T3gi/System/docs/pinout.md

# Схема підключення та Pinout

## 1. Зведена таблиця підключення

| Пін МК | Номер AF | Периферія і сигнал | Роз'єм Nucleo (Morpho / Arduino) | Пін пристрою | Напруга | Pull-up/down | Джерело | Причина вибору (Чому саме цей пін) |
| :--- | :--- | :--- | :--- | :--- | :--- | :--- | :--- | :--- |
| **Камера OV7670** | | | | | | | | |
| PB8 | AF4 | I2C1_SCL | CN5 pin 10 (D15) | SIO_C | 3.0V | Pull-up (МК) | DS10314[pg:48]; UM1724[pg:44]; OV7670[pg:4-5] | Апаратна підтримка I2C1_SCL. Стандартний пін Arduino роз'єму. |
| PB9 | AF4 | I2C1_SDA | CN5 pin 9 (D14) | SIO_D | 3.0V | Pull-up (МК) | DS10314[pg:48]; UM1724[pg:44]; OV7670[pg:4-5] | Апаратна підтримка I2C1_SDA. Стандартний пін Arduino роз'єму. |
| PA8 | AF0 | MCO_1 (Clock) | CN9 pin 8 (D7) | XCLK | 3.0V | Без підтяжки | DS10314[pg:48]; UM1724[pg:44]; OV7670[pg:4-5] | Єдиний пін (MCO_1), що може апаратно виводити тактову частоту з ядра МК. |
| PC0 | Input | GPIO_Input | CN7 pin 38 | D0 | 3.0V | Pull-down (МК)| DS10314[pg:48]; UM1724[pg:59]; OV7670[pg:4-5] | Початок цілісного порту GPIOC для паралельного зчитування байта за 1 такт. |
| PC1 | Input | GPIO_Input | CN7 pin 36 | D1 | 3.0V | Pull-down (МК)| DS10314[pg:48]; UM1724[pg:59]; OV7670[pg:4-5] | Продовження цілісного порту GPIOC. |
| PC2 | Input | GPIO_Input | CN7 pin 35 | D2 | 3.0V | Pull-down (МК)| DS10314[pg:48]; UM1724[pg:59]; OV7670[pg:4-5] | Продовження цілісного порту GPIOC. |
| PC3 | Input | GPIO_Input | CN7 pin 37 | D3 | 3.0V | Pull-down (МК)| DS10314[pg:48]; UM1724[pg:59]; OV7670[pg:4-5] | Продовження цілісного порту GPIOC. |
| PC4 | Input | GPIO_Input | CN10 pin 34 | D4 | 3.0V | Pull-down (МК)| DS10314[pg:48]; UM1724[pg:59]; OV7670[pg:4-5] | Продовження цілісного порту GPIOC. |
| PC5 | Input | GPIO_Input | CN10 pin 6 | D5 | 3.0V | Pull-down (МК)| DS10314[pg:48]; UM1724[pg:59]; OV7670[pg:4-5] | Продовження цілісного порту GPIOC. |
| PC6 | Input | GPIO_Input | CN10 pin 4 | D6 | 3.0V | Pull-down (МК)| DS10314[pg:48]; UM1724[pg:59]; OV7670[pg:4-5] | Продовження цілісного порту GPIOC. |
| PC7 | Input | GPIO_Input | CN10 pin 19 | D7 | 3.0V | Pull-down (МК)| DS10314[pg:48]; UM1724[pg:59]; OV7670[pg:4-5] | Кінець цілісного порту GPIOC. |
| PA0 | Input | EXTI0 | CN8 pin 1 (A0) | PCLK | 3.0V | Без підтяжки | DS10314[pg:48]; UM1724[pg:44]; OV7670[pg:4-5] | Канал EXTI0 для найшвидшого переривання по піксельному такту. |
| PA1 | Input | GPIO_Input | CN8 pin 2 (A1) | VSYNC | 3.0V | Без підтяжки | DS10314[pg:48]; UM1724[pg:44]; OV7670[pg:4-5] | Сусідній вільний пін, зручно виведений на колодку A1 для підключення. |
| PA4 | Input | GPIO_Input | CN8 pin 3 (A2) | HREF | 3.0V | Без підтяжки | DS10314[pg:48]; UM1724[pg:44]; OV7670[pg:4-5] | Сусідній вільний пін, зручно виведений на колодку A2 для підключення. |
| PB1 | Output| GPIO_Output | CN10 pin 24 | RESET | 3.0V | Без підтяжки | DS10314[pg:48]; UM1724[pg:59]; OV7670[pg:4-5] | Вільні піни порту B, розташовані поруч на роз'ємі Morpho для зручності шлейфу. |
| PB2 | Output| GPIO_Output | CN10 pin 22 | PWDN | 3.0V | Без підтяжки | DS10314[pg:48]; UM1724[pg:59]; OV7670[pg:4-5] | Сусідній до PB1 пін, використовується для живлення. |
| **MPU-6050 (GY-89)** | | | | | | | | |
| PB8 | AF4 | I2C1_SCL | Спільна лінія | SCL | 3.3V | Pull-up (модуль)| DS10314[pg:48]; MPU-6000P[pg:5]| Підключено паралельно на апаратну шину I2C1 разом з камерою. |
| PB9 | AF4 | I2C1_SDA | Спільна лінія | SDA | 3.3V | Pull-up (модуль)| DS10314[pg:48]; MPU-6000P[pg:5]| Підключено паралельно на апаратну шину I2C1 разом з камерою. |
| **SPI Flash W25Q64** | | | | | | | | |
| PB13 | AF5 | SPI2_SCK | CN10 pin 30 | CLK | 3.3V | Без підтяжки | DS10314[pg:48]; W25Q64JV[pg:5,58]| Апаратна підтримка SPI2. Використано, бо SPI1 зайнятий таймером серво. |
| PB14 | AF5 | SPI2_MISO | CN10 pin 28 | MISO | 3.3V | Без підтяжки | DS10314[pg:48]; W25Q64JV[pg:5,58]| Апаратна підтримка SPI2. Піни PB13-PB15 йдуть підряд на Morpho. |
| PB15 | AF5 | SPI2_MOSI | CN10 pin 26 | MOSI | 3.3V | Без підтяжки | DS10314[pg:48]; W25Q64JV[pg:5,58]| Апаратна підтримка SPI2. |
| PB12 | Output| GPIO_Output | CN10 pin 16 | CS | 3.3V | Pull-up (МК) | DS10314[pg:48]; W25Q64JV[pg:5,58]| Сусідній до шини SPI2 пін для зручного підключення шлейфом (NSS програмний). |
| **Сервопривід** | | | | | | | | |
| PA6 | AF2 | TIM3_CH1 | CN5 pin 5 (D12) | Signal | 5.0V | Без підтяжки | DS10314[pg:48]; UM1724[pg:44]| Має апаратний вивід каналу таймера (TIM2_CH1) для генерації ШІМ (PWM). |
# Arduino - CN5,CN6,CN8,CN9 
# Morpho - CN7,CN10

## 2. Таблиця адрес і ідентифікаторів пристроїв

| Пристрій | Шина | Адреса вибору на модулі | Робоча I2C-адреса (Write / Read) | Очікувані значення регістрів ідентифікації | Джерело |
| :--- | :--- | :--- | :--- | :--- | :--- |
| **OV7670** | I2C1 (SCCB) | Апаратно фіксована | `0x42` (Write) / `0x43` (Read) | PID (`0x0A`) = `0x76`, VER (`0x0B`) = `0x70` | OV7670 Datasheet [pg:10-23] |
| **MPU-6050** | I2C1 | Пін AD0 підтягнутий до GND (на модулі GY-89) | `0xD0` (Write) / `0xD1` (Read) [7-bit: `0x68`] | WHO_AM_I (Регістр 117 / `0x75`) = `0x68` | MPU-6000 [pg:45] |
| **W25Q64JV** | SPI2 | Не застосовно (використовується Chip Select) | Не застосовно (SPI) | Команда `0x9F` (JEDEC) повертає: `0xEF4017` | W25Q64JV Datasheet [pg:20, 58] |

## 3. Параметри шин та тактування

* **SYSCLK (Частота ядра):**
  * **Значення:** Максимальна частота STM32F411 становить 100 МГц.
  * **Джерело:** DS10314 \[pg: 1\]

* **I2C1 (Камера OV7670 та MPU-6050):**
  * **Режим:** Standard Mode (100 kHz).
  * **Дерево тактування:** Підключено до шини APB1 (максимум 50 МГц). Якщо `SYSCLK = 84 МГц`, то `APB1 = 42 МГц` (Prescaler = 2).
  * **Розрахунок:** Прескалер шини I2C розраховується апаратно (зазвичай через бібліотеку HAL) так, щоб з базової частоти 42 МГц отримати період тактування $10 \mu s$ (100 кГц).
  * **Джерело:** DS10314 \[pg: 54-57\]

* **SPI2 (Флеш-пам'ять W25Q64JV):**
  * **Режим:** Full-Duplex Master, SPI Mode 0 (CPOL=0, CPHA=0).
  * **Дерево тактування:** Підключено до шини APB1 (наприклад, 42 МГц).
  * **Прескалер та розрахунок:** Обрано дільник **Prescaler = 4**. Робоча частота шини складе: `42 МГц / 4 = 10.5 МГц`. 
  * **Обґрунтування:** Частота 10.5 МГц є оптимальною для стабільної передачі сигналів макетними проводами і повністю вписується в ліміт мікросхеми пам'яті (яка підтримує частоти до 133 МГц).
  * **Джерела:** DS10314 \[pg: 54-57\]; W25Q64JV Datasheet \[pg: 4, 11, 62\]

* **MCO_1 (Тактування камери XCLK):**
  * **Режим:** Апаратний вивід тактового сигналу через альтернативну функцію AF0 на пін PA8.
  * **Прескалер та розрахунок:** Як джерело обрано генератор **HSI (16 МГц)**. Подільник для MCO_1 встановлено на **2**. Розрахунок вихідної частоти: `16 МГц / 2 = 8 МГц`. 
  * **Обґрунтування:** Частота 8 МГц необхідна для тактування внутрішньої логіки сенсора OV7670.
  * **Джерело:** DS10314 \[pg: 48-53\]

## 4. Бюджет живлення

*Джерело струму для логічної лінії 3V3 плати Nucleo: вбудований LDO-регулятор U4, максимальний струм якого обмежений на рівні **500 мА**. (Джерело: UM1724 [pg: 23])*

| Пристрій | Джерело живлення | Робоче (типове) споживання | Пікове (максимальне) споживання | Обґрунтування окремого джерела живлення |
| :--- | :--- | :--- | :--- | :--- |
| **OV7670** | Nucleo 3.3V | ~15 мА | ~20 мА | - |
| **MPU-6050** | Nucleo 3.3V | ~3.9 мА | ~5 мА | - |
| **W25Q64JV** | Nucleo 3.3V | ~15 мА | ~25 мА | - |
| **STM32F411** | Nucleo 3.3V | ~20 мА | ~25 мА | - |
| ***Всього (лінія 3.3V)*** | | ***~53.9 мА*** | ***~75 мА*** | **Запас по струму для лінії 3.3V: ~425 мА (більше 80% запасу). Це гарантує стабільну роботу цифрової логіки.** |
| **SG92R (Серво)** | **Nucleo 5V (від USB)** | ~100 мА | **> 500 мА** | Сервопривід є індуктивним навантаженням. Його пускові струми або струми при блокуванні ротора перевищують весь ліміт стабілізатора U4. Підключення до лінії 3.3V гарантовано викличе просадку напруги та апаратне перезавантаження (Brownout) мікроконтролера. Тому силове живлення винесено на лінію 5V безпосередньо від USB. |

## 5. Аргументація архітектурних рішень
* **Зчитування камери цілим портом (PC0-PC7):** Оскільки МК не має апаратного інтерфейсу DCMI, дані зчитуються програмно. Підключення D0-D7 суворо до одного порту `GPIOC` дозволяє зчитати 8-бітний піксель за одну атомарну операцію (`GPIOC->IDR & 0xFF`), що життєво необхідно для відеопотоку.
* **Апаратні шини (I2C1, SPI2):** Піни PB8/PB9 та PB13-PB15 обрані через апаратну підтримку цих інтерфейсів, що знімає процесорне навантаження (не потрібен bit-banging) і дає можливість у майбутньому підключити DMA до SPI.

## 6. Відхилені варіанти (Альтернативні розкладки)
1. **Відхилений варіант 1: Використання піна PA5 (TIM2_CH1) для генерації ШІМ-сигналу сервопривода.**
   * *Причина відмови:* На платі Nucleo пін PA5 апаратно з'єднаний із вбудованим зеленим світлодіодом (LD2). Якби ми залишили на ньому керування сервоприводом, постійна генерація високочастотного ШІМ-сигналу викликала б неконтрольоване та дратівливе мерехтіння цього світлодіода під час роботи пристрою. Крім того, це створює непотрібне електричне навантаження на лінію. Тому керування було перенесено на сусідній, повністю вільний пін PA6 (TIM3_CH1).
2. **Відхилений варіант 2: Зчитування пікселів камери (D0-D7) через випадкові вільні піни GPIOA та GPIOB.**
   * *Причина відмови:* Якби контакти D0-D7 були рознесені на різні порти (наприклад, D0 на PA2, D1 на PB4 тощо), обробка кожного переривання PCLK вимагала б кількох операцій зчитування, маскування (AND) та бітових зсувів. Це займає десятки тактів процесора, через що МК банально не встигав би зчитувати пікселі на частоті камери 8 МГц.
