T3gi/System/docs/limitations.md

# Реєстр обмежень архітектури Super Loop (на базі аналізу тестування)

У цьому документі наведено 5 критичних обмежень поточної архітектури "суперциклу" (Super Loop), виявлених під час тестування системи (зокрема сценаріїв зйомки та навантаження), а також шляхи їх вирішення за допомогою ОСРЧ (RTOS).

## 1. Затримка реакції на апаратні події (Відсутність витіснення)
*   **Опис проблеми:** У суперциклі всі задачі виконуються послідовно. Якщо функція `App_Poll()` "застрягає" на тривалій операції (наприклад, читання кадру камери через блокуючий SPI або вивантаження масиву 22 КБ по UART), обробка інших подій зупиняється. У нашому випадку натискання кнопки `B1_Pin` фіксується в перериванні миттєво (`btn_pending = 1`), але його *обробка* (виклик логіки камери) затримується на сотні мілісекунд (максимум до 107 мс і більше), оскільки суперцикл зайнятий іншим кодом.
*   **Рішення з RTOS:** ОСРЧ підтримує **витіснювальну багатозадачність (preemptive scheduling)**. Обробник кнопки можна винести у задачу з високим пріоритетом. Як тільки користувач натискає кнопку, RTOS негайно призупиняє задачу передачі кадру (яка матиме нижчий пріоритет) і передає управління задачі обробки кнопки, зводячи затримку до кількох мікросекунд.

## 2. Неможливість дотримання жорсткого таймінгу (Джитер періодичних задач)
*   **Опис проблеми:** Подія `TICK`, яка має генеруватися рівно кожні 1000 мс для опитування датчика температури та освітленості, страждає від величезного джитера (відхилення часу). У сценарії навантаження джитер перевищує 2 секунди. Суперцикл не гарантує детермінованості: час виконання циклу постійно "плаває" залежно від гілок `if/else`, які в ньому виконуються.
*   **Рішення з RTOS:** В ОСРЧ періодичні задачі можна реалізувати за допомогою функції `vTaskDelayUntil()` або програмних таймерів. Планувальник гарантує, що задача опитування датчиків "прокинеться" рівно через 1000 мс. Якщо в цей час виконується менш пріоритетна задача (наприклад, розрахунок статистики чи вивід логів), вона буде витіснена.

## 3. Неефективне використання CPU (Busy-waiting)
*   **Опис проблеми:** Коли мікроконтролер очікує завершення передачі даних по I2C або UART (використовуючи `HAL_UART_Transmit`), він просто крутиться в нескінченному циклі опитування прапорців усередині HAL. У цей час показник `LOAD` сягає 100%. Процесор марнує мільйони тактів, не виконуючи корисної роботи, і не дає іншим модулям працювати.
*   **Рішення з RTOS:** Задачі в RTOS можуть переходити у стан **Blocked (Заблоковано)**. Використовуючи механізми синхронізації (наприклад, семафори з переривань DMA або I2C), задача, що очікує даних, "засинає". RTOS віддає процесорний час іншим задачам (наприклад, оновленню екрану чи опитуванню кнопок). Навантаження на CPU стрімко падає.

## 4. Складність підтримки коду (Макаронні кінцеві автомати)
*   **Опис проблеми:** Щоб уникнути повного зависання в суперциклі, тривалі операції (як-от робота з камерою) доводиться розбивати на дрібні шматки за допомогою складних кінцевих автоматів (State Machines) з великою кількістю глобальних прапорців (на кшталт `btn_pending`, `capture_state` тощо). Код стає заплутаним, його важко читати, дебажити та масштабувати.
*   **Рішення з RTOS:** RTOS дозволяє писати код **лінійно**. Кожна задача має свій власний незалежний контекст (і свій стек). Можна просто викликати функцію очікування кадру, і вона заблокує лише поточну задачу, не впливаючи на весь інший код. Глобальні змінні стану замінюються безпечними чергами (Queues) та семафорами.

## 5. Проблеми з енергоефективністю
*   **Опис проблеми:** У файлі `main_2.c` ми бачимо, що `while(1)` постійно крутиться, розраховуючи `busy_cycles` та викликаючи `App_Poll()`. Навіть коли системі нічого робити (датчики опитані, камера вимкнена), процесор продовжує працювати на максимальній частоті 84 МГц, споживаючи максимум енергії.
*   **Рішення з RTOS:** ОСРЧ має вбудовану задачу **Idle Task** (задача простою), яка виконується тоді, коли всі інші задачі заблоковані або очікують подій. В Idle Task можна додати виклик інструкції `WFI` (Wait For Interrupt) або перехід мікроконтролера в режим сну (Sleep Mode/Tickless Idle). Це дозволяє кардинально знизити енергоспоживання пристрою без ускладнення прикладного коду.
