T3gi/System/docs/captures/screenshots/LR3/btn-latency.png

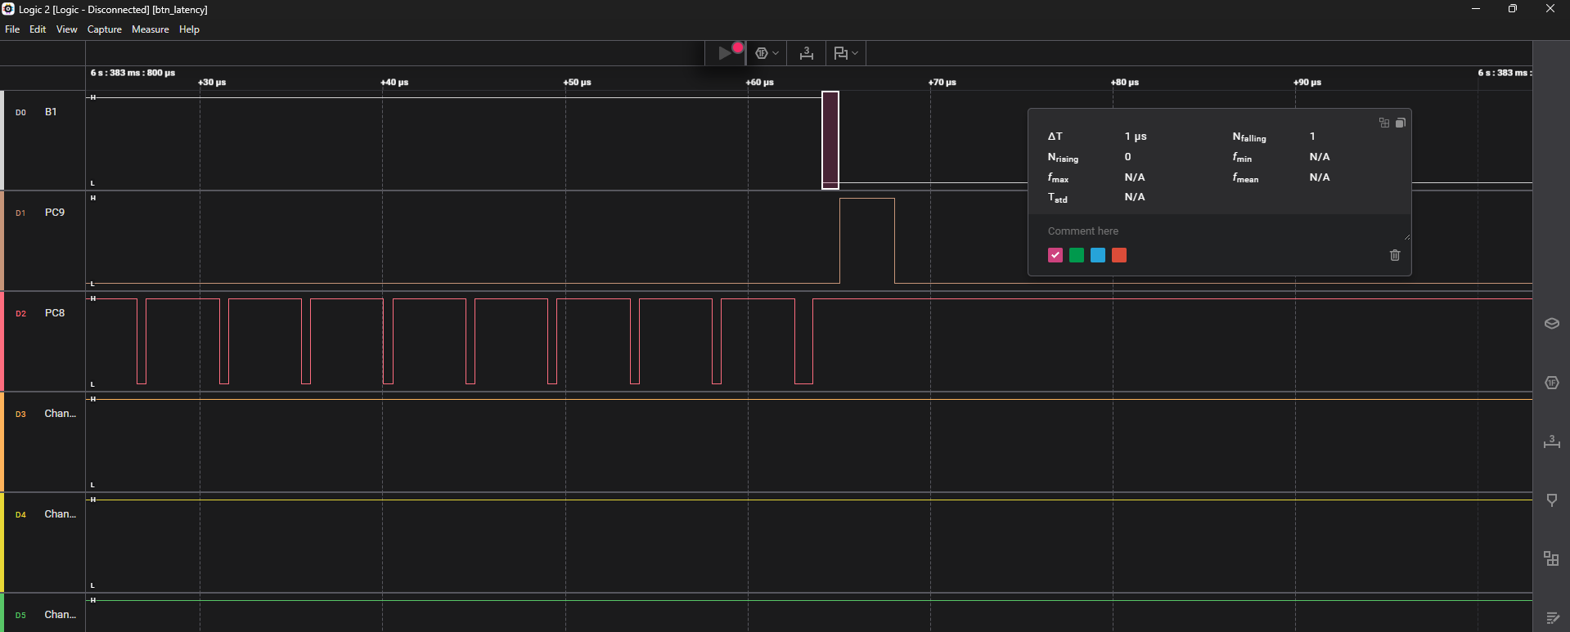
docs/captures/screenshots/LR3/btn-latency.png
