T3gi/System/docs/captures/screenshots/LR3/frame-gap.png

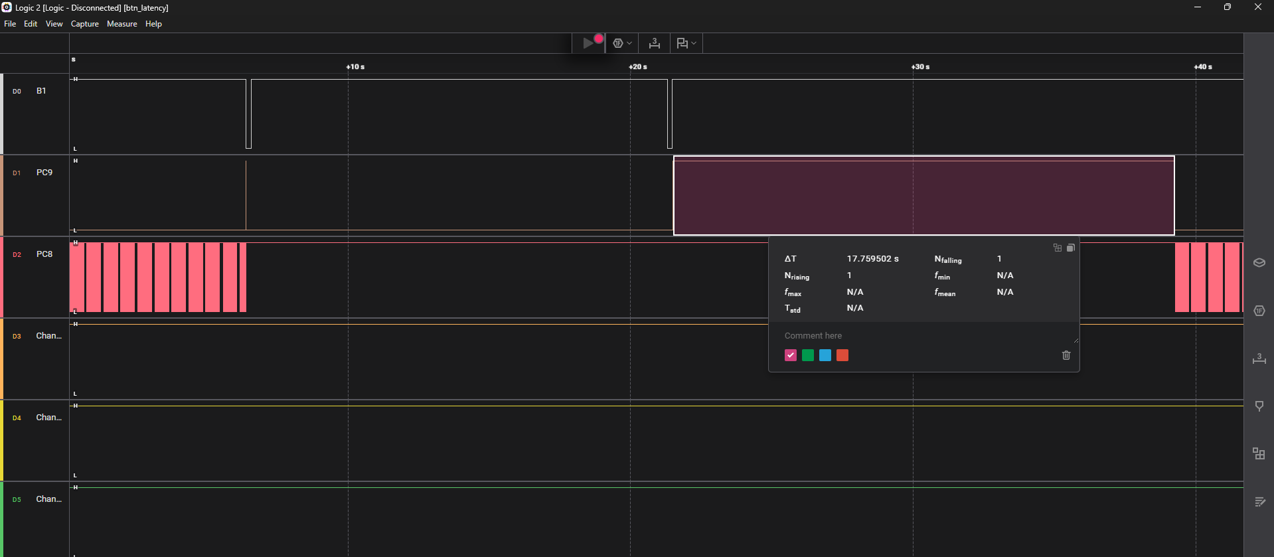
docs/captures/screenshots/LR3/frame-gap.png
