T3gi/System/docs/screenshots/Clock Configuration.png

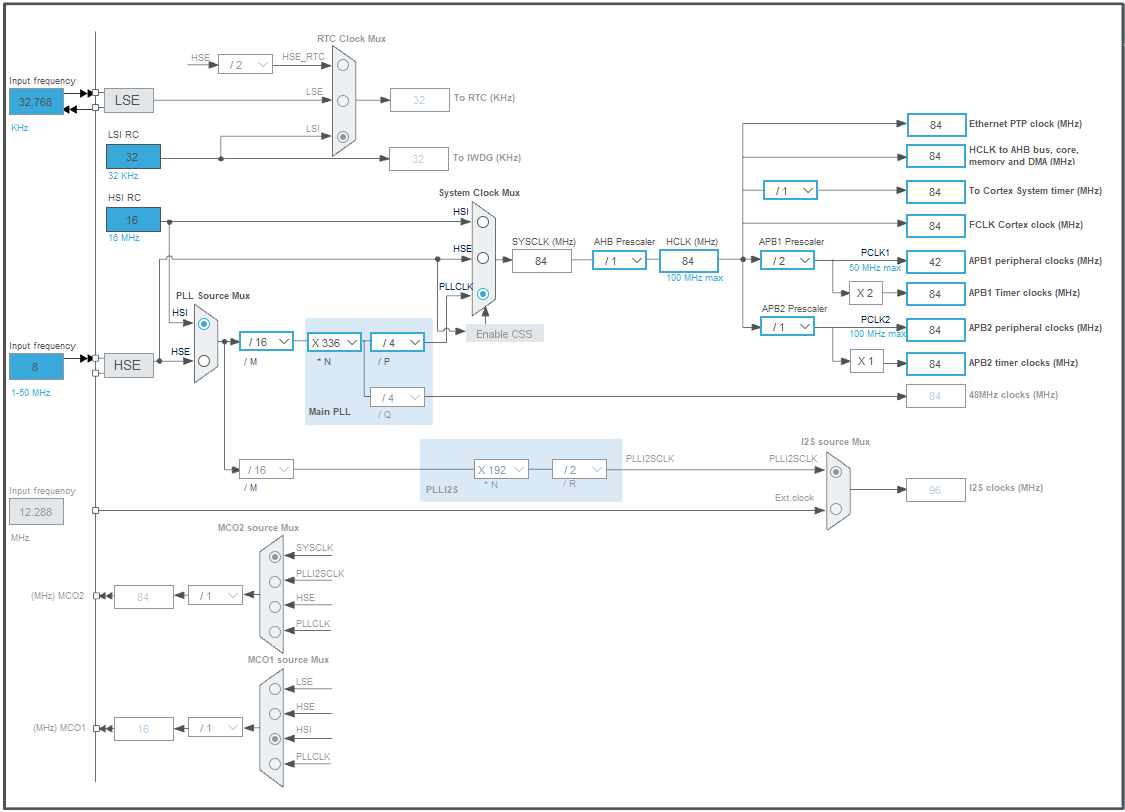
docs/screenshots/Clock Configuration.png
