T3gi/System/docs/screenshots/Logic analyzer capture.png

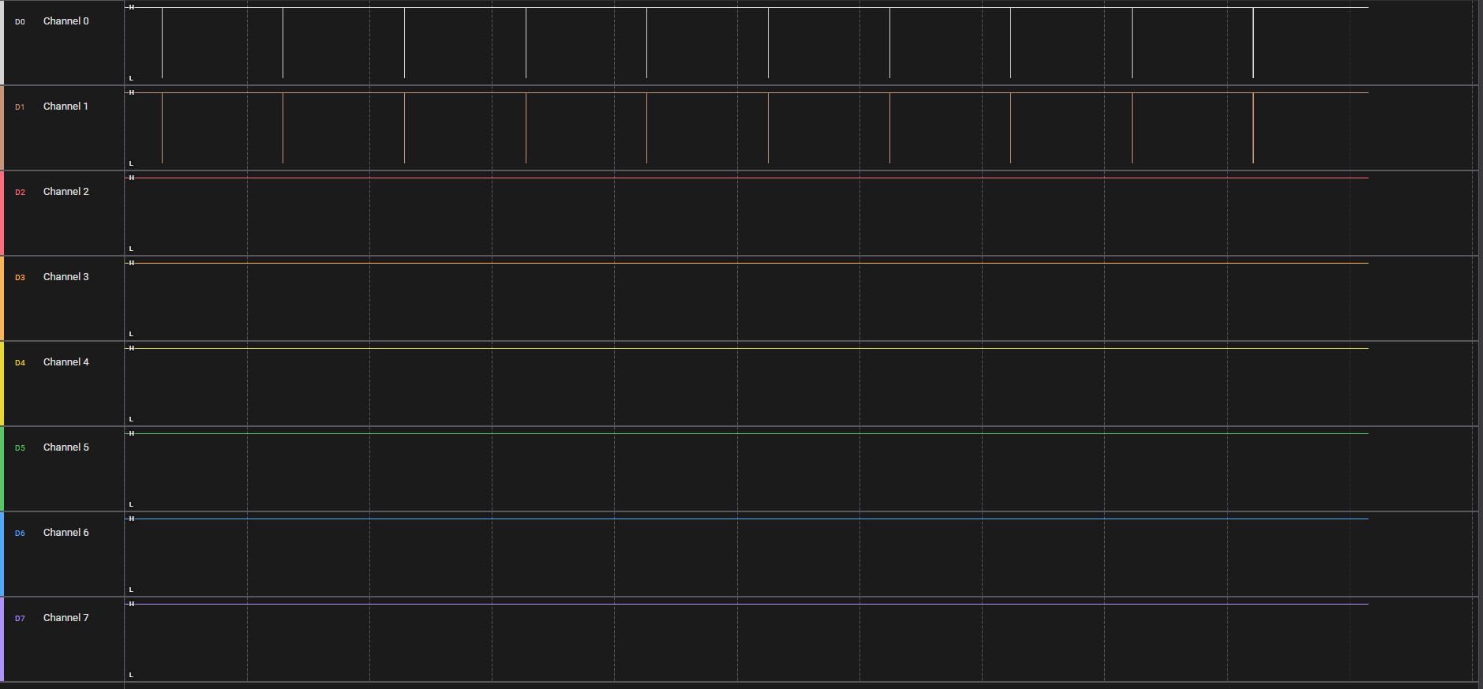
docs/screenshots/Logic analyzer capture.png
