T3gi/System/docs/screenshots/Picocom.png

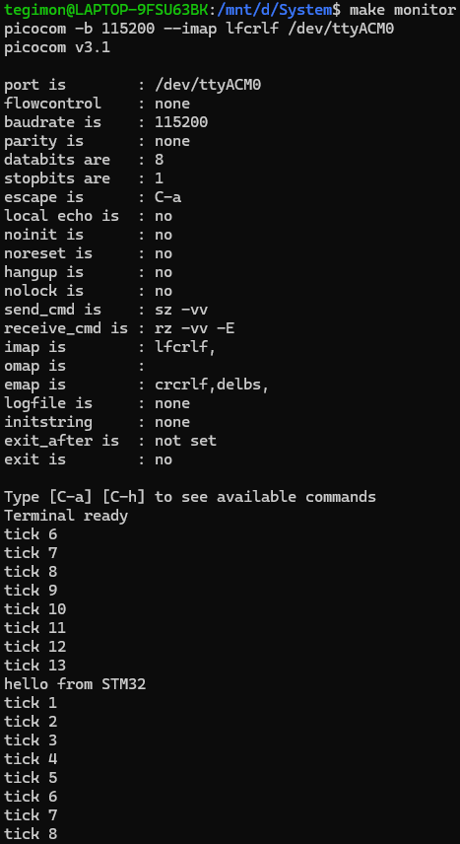
docs/screenshots/Picocom.png
