T3gi/System/docs/screenshots/Pinout(2).jpg

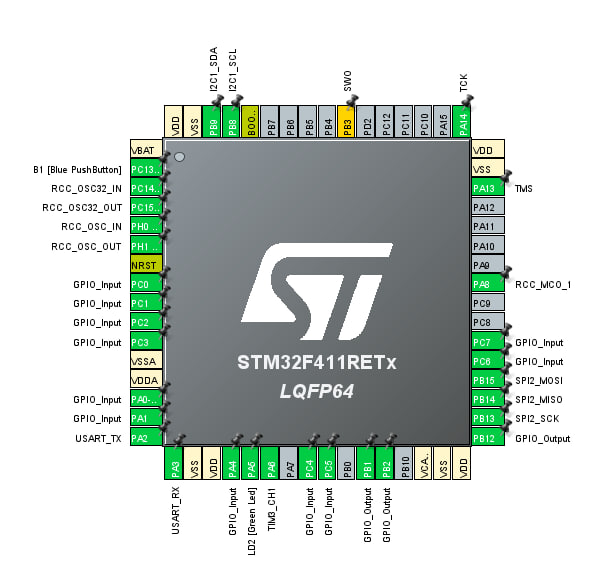
docs/screenshots/Pinout(2).jpg
