T3gi/System/docs/screenshots/Pinout.png

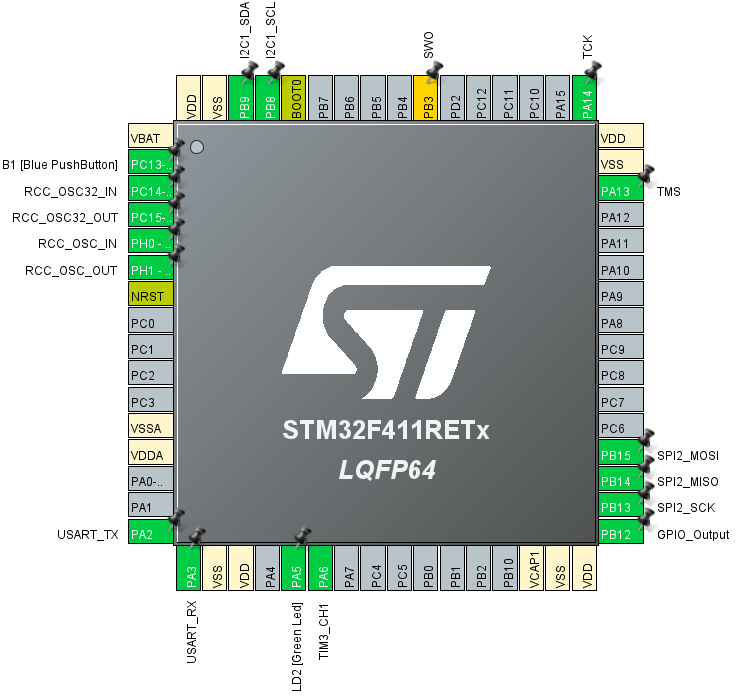
docs/screenshots/Pinout.png
