T3gi/System/firmware/firmware.ioc

Mcu.UserName=STM32F411RETx
PA0-WKUP.Signal=GPIO_Input
PA1.Signal=GPIO_Input
PA13.GPIO_Label=TMS
PA13.Signal=SYS_JTMS-SWDIO
PA14.GPIO_Label=TCK
PA14.Signal=SYS_JTCK-SWCLK
PA2.GPIO_Label=USART_TX
PA2.Signal=USART2_TX
PA3.GPIO_Label=USART_RX
PA3.Signal=USART2_RX
PA4.Signal=GPIO_Input
PA5.GPIO_Label=LD2 [Green Led]
PA5.Signal=GPIO_Output
PA6.Signal=S_TIM3_CH1
PA8.Signal=S_TIM1_CH1
PB1.Signal=GPIO_Output
PB12.Signal=GPIO_Output
PB13.Signal=SPI2_SCK
PB14.Signal=SPI2_MISO
PB15.Signal=SPI2_MOSI
PB2.Signal=GPIO_Output
PB3.GPIO_Label=SWO
PB3.Signal=SYS_JTDO-SWO
PB8.Signal=I2C1_SCL
PB9.Signal=I2C1_SDA
PC0.Signal=GPIO_Input
PC1.Signal=GPIO_Input
PC13-ANTI_TAMP.GPIO_Label=B1 [Blue PushButton]
PC13-ANTI_TAMP.Signal=GPXTI13
PC14-OSC32_IN.Signal=RCC_OSC32_IN
PC15-OSC32_OUT.Signal=RCC_OSC32_OUT
PC2.Signal=GPIO_Input
PC3.Signal=GPIO_Input
PC4.Signal=GPIO_Input
PC5.Signal=GPIO_Input
PC6.Signal=GPIO_Input
PC7.Signal=GPIO_Input
