T3gi/System/(commit log)

2026-09-22 Add make flash and monitor commands, implement first UART response
2026-09-25 Pinout change + UART response change + I2C signal added + Screenshots
2026-10-12 build: init STM32 project, add platform wrappers and setup CI/CD
2026-10-17 Devices init and register check
2026-10-19 Added camera functionality + temperature check
2026-11-05 camera timing fix, unit tests, loop description
